VladVeliciu/PWM_generator/README.md

# PWM_generator (01/04/2022 - 17/05/2022)
- Circuit was designed in LTSpice simulator with theoretically calculations and standardization of components
- Simulations to demonstrate the functionality of the circuit with the standard, real components (with tolerances)
- Documentation to explain the computing, design, standardization and simulation process
