VladVeliciu/PWM_generator/PWM Generator.pptx

## PWM Generator

Vlad Veliciu
Faculty of Electronics, Telecommunication and Information Technology, TUC-N

## Description and functionality of the circuit

- Design parameters:
  - Duty cycle: 10%-50%
  - Amplitude: 3V-5V
  - F=12000 Hz

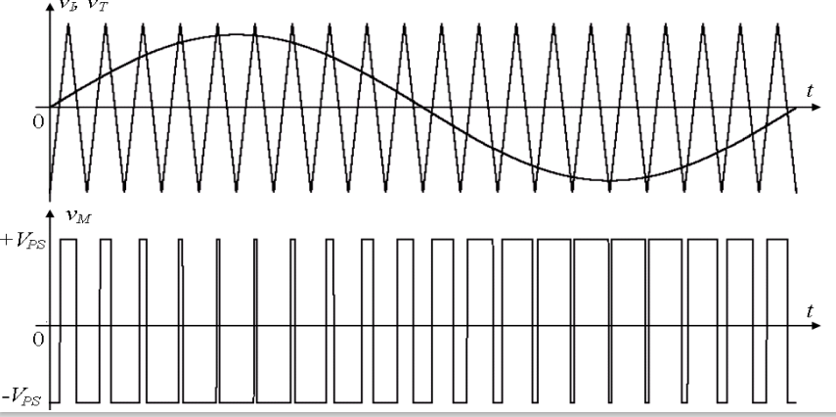
[picture p1: figure]
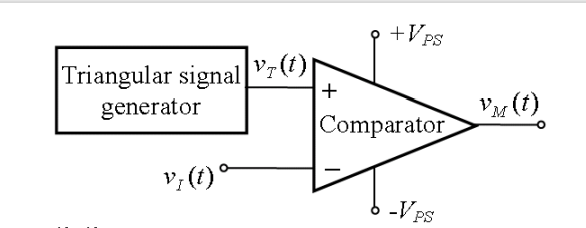
[picture p2: figure]

Vi(t) can be a sine wave or a DC signal

## Block Diagram

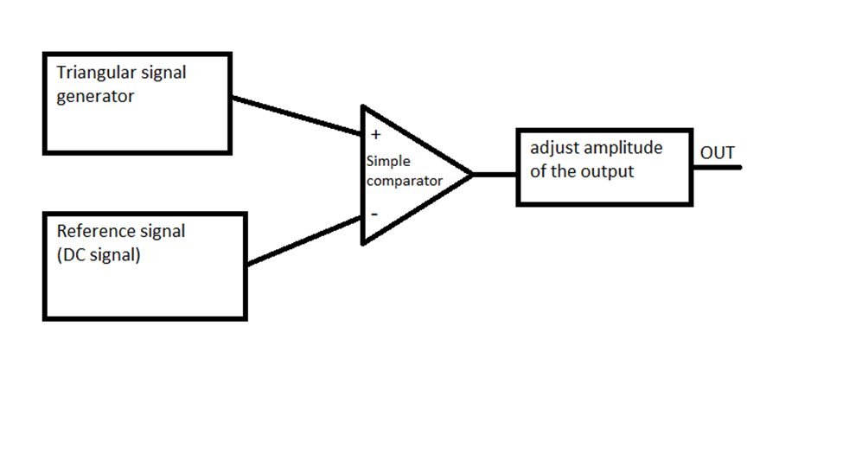
[picture p3: figure]

## Electrical schematic and theoretically computed values for components

- Triangular signal generator
  - Design formula: f=(R_2)/(4∗R∗C∗R_1)=12000 where R2>R1 (necessary condition for oscillation). Take R2=2∗R1
  - {, R_1 =2kΩ, R_2 =4kΩ, R=8kΩ, C=5.2nF
  - R5=R=2kΩ; R6=R1||R2=1.34kΩ
  - For VTriang: V_(max) =3V and V_(min) =−3V

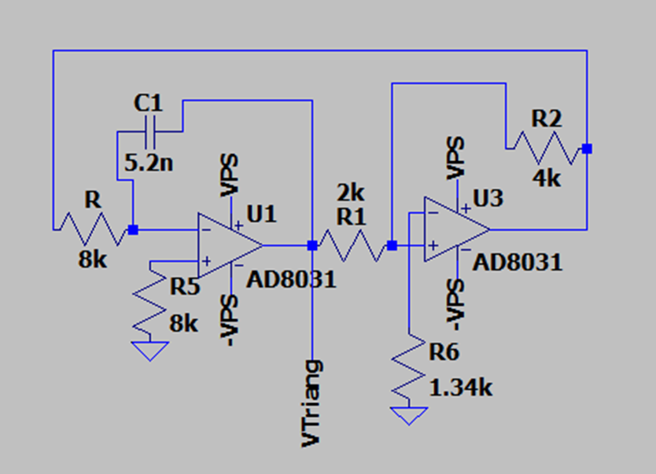
[picture p4: figure]

VPS=6V

## Electrical schematic and theoretically computed values for components

- Reference (DC) signal
  - D=(T_(on))/T∗100
  - For D=10% (whole R7 used) ->
(Ampl of V_(Triang))/(, , Ampl of V_(Triang) −VIN)=(T/2)/(t_(in))=>VIN=2.4 V
  - For D=50% (R7 not used) => VIN=0 V
  - By applying voltage divider: R_7 =1kΩ and R_4 =1.5kΩ

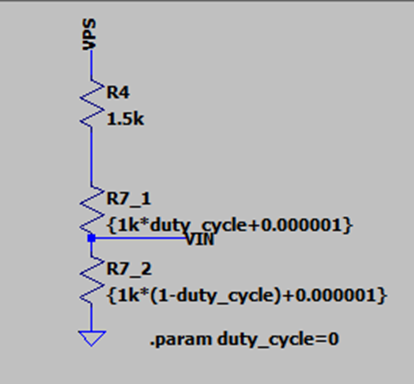
[picture p5: figure]
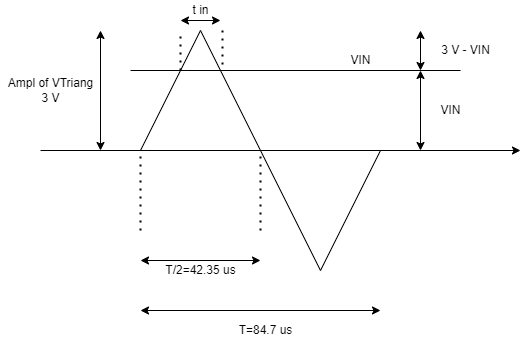
[picture p6: figure]

## Electrical schematic and theoretically computed values for components

- Simple comparator
  - At every intersection of VIN with VTriang, a switch of the output signal (between VPS and –VPS) happens

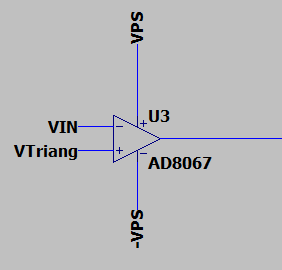
[picture p7: figure]

## Electrical schematic and theoretically computed values for components

- Adjust amplitude at the output circuit
  - R_8 =1k , R_9 =0.5kΩ and R_3 =1.5kΩ
  - Class B amplifier with global negative feedback (neglectable distortions)
  - Needs a higher voltage supply than the “followed” -> VPS=6V

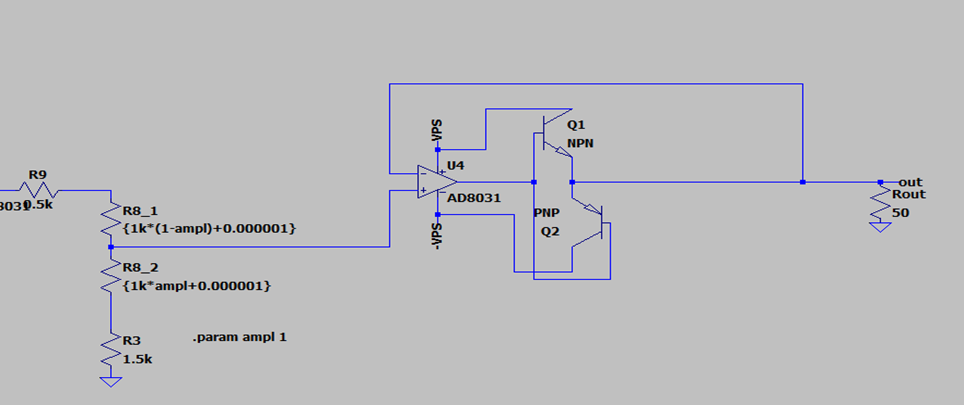
[picture p8: figure]

## Electrical schematic and theoretically computed values for components

- Schematic with theoretically computed values

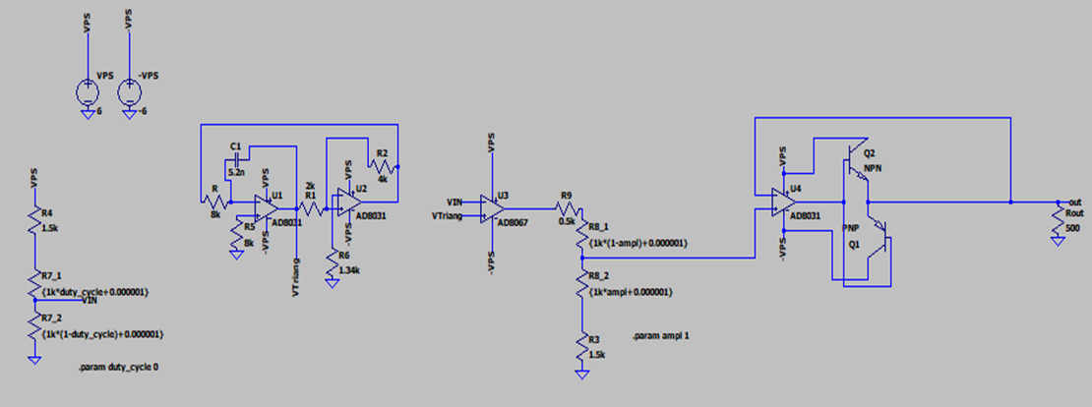
[picture p9: figure]

## Choosing standard components

- OpAmps
  - Rail-to-rail AD8031 - triangular signal generator and class B amplifier (slew rate=30V/us), low power amplifier
  - Rail-to-rail AD8067 – simple comparator (slew rate=640V/us) -> quick stabilization

## Choosing standard components

- Passive components and transistors
  - C1=5.1 nF (+/- 10%)
  - R1=2 kΩ (+/- 0.5%)
  - R2=4.02 kΩ (+/- 0.05%)
  - R=R5=8.06 kΩ (+/- 0.5%)
  - R6=1.35 kΩ (+/- 5%)
  - R4=1.5 kΩ (+/- 1%)
  - R7=1 kΩ (+/- 20%)
  - R9=2 kΩ (+/- 0.1%)
  - R8=1 kΩ (+/- 20%)
  - R3=1.5 kΩ (+/- 1%)
  - Q2=BJT npn 2N2222 (Ic=600 mA)
  - Q1=BJT pnp 2N2907 (Ic=600 mA)

## Simulations and Analysis

- Time-domain simulation
- Amplitude=5V
- VIN=2.4V
- D=10%

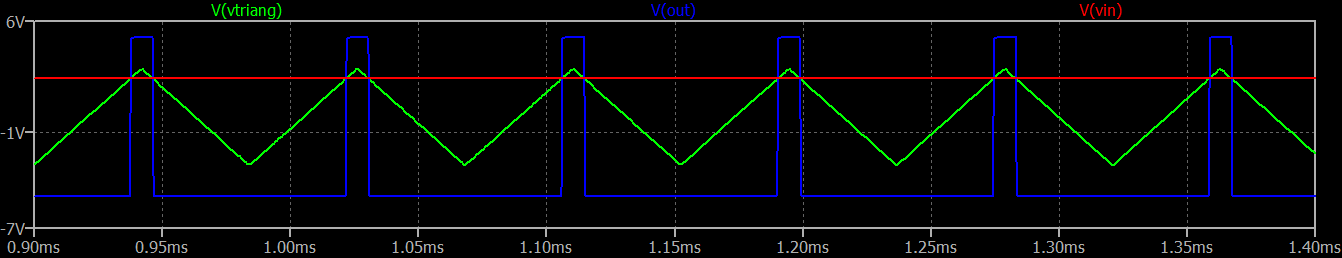
[picture p10: figure]

F=11874 Hz

## Simulations and Analysis

- Parametric analysis – varying duty cycle (potentiometer R7)
  - VIN variation:

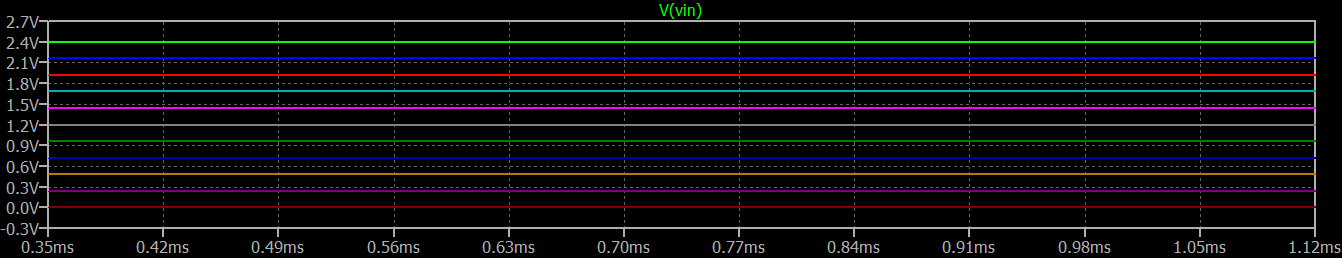
[picture p11: figure]
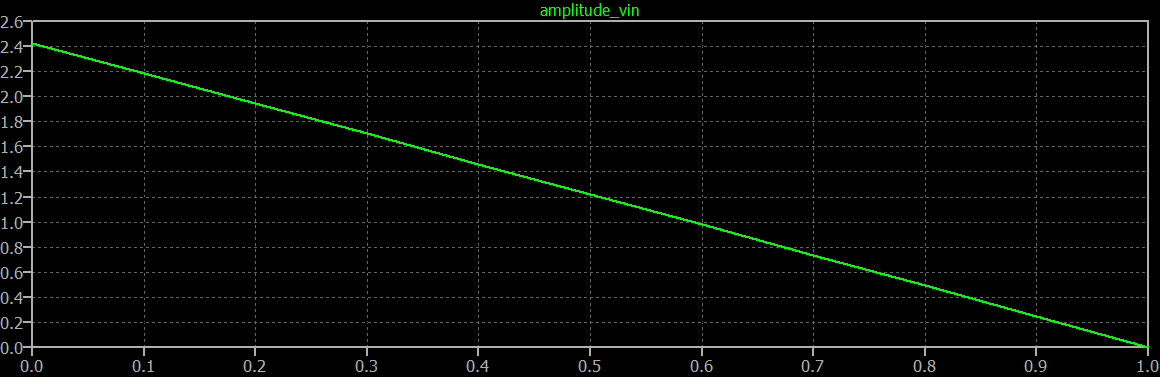
[picture p12: figure]

VIN decreases (2.4V-0V) linearly with the increase of the percentage of the used potentiometer

## Simulations and Analysis

- Parametric analysis – varying duty cycle
  - Vout variation: (Amplitude=5V)

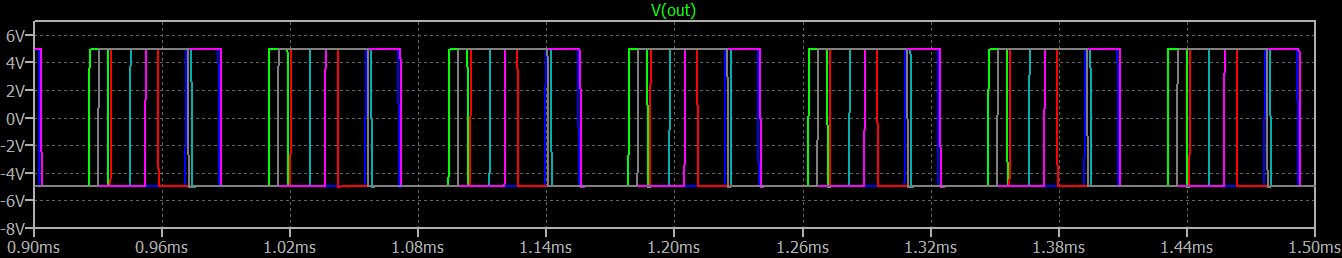
[picture p13: figure]
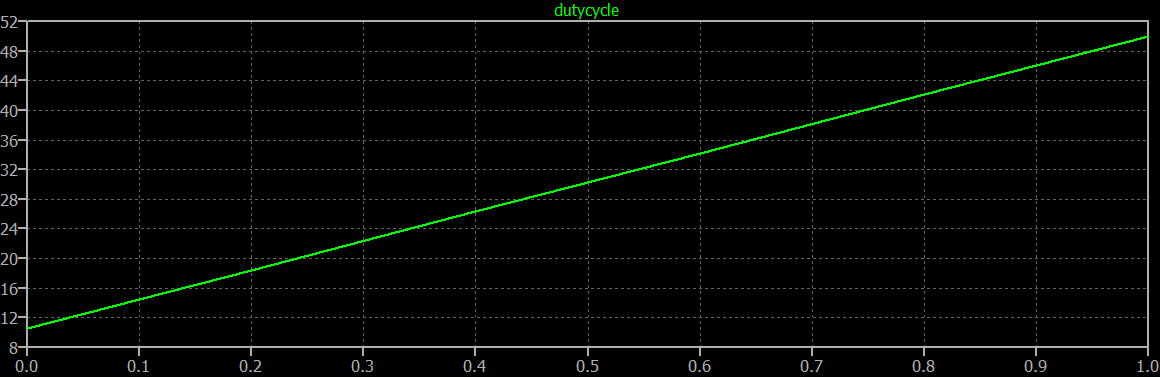
[picture p14: figure]

Duty cycle varies linearly

## Simulations and Analysis

- Parametric analysis – varying amplitude (potentiometer R8)
  - Vout variation (duty cycle=50%)

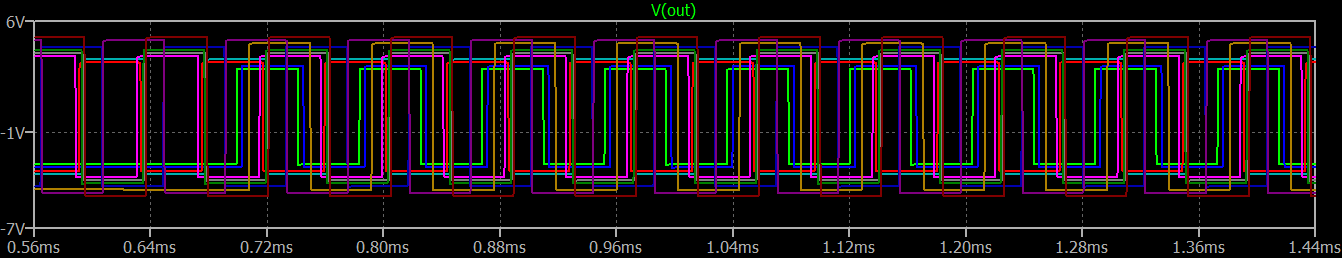
[picture p15: figure]
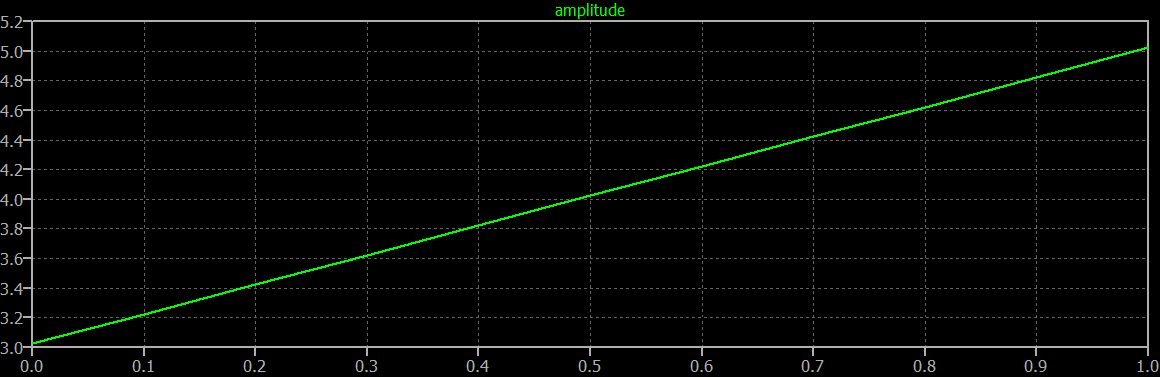
[picture p16: figure]

Amplitude varies linearly

## Simulations and Analysis

- FFT (Fast Fourier Transform)
  - Output signal (rectangular)
  - Ampl=5V, D=50%

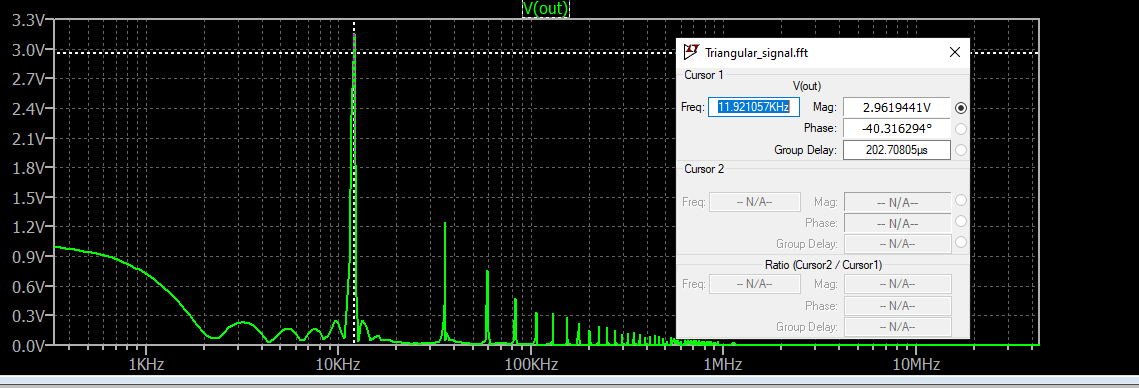
[picture p17: figure]

2/T ∗A∗τ∗sinc(π∗n∗f∗τ)

At f=12kHz => Spectrum = 3.18V

## Simulations and Analysis

- FFT (Fast Fourier transform)
  - Triangular signal (Amplitude = 3V):

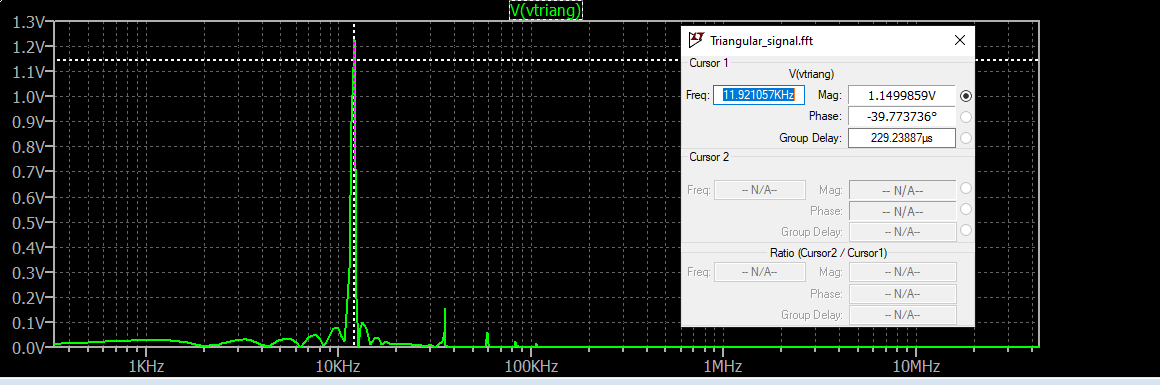
[picture p18: figure]

2/T ∗A∗τ/2∗sinc^2 (π∗n∗f∗τ/2)

For f=12kHz => Spectrum = 1.21 V

## Simulations and Analysis

- Monte Carlo analysis
  - Adding tolerances to the components
  - Variation of Vout in time (Ampl=5V, D=10%):

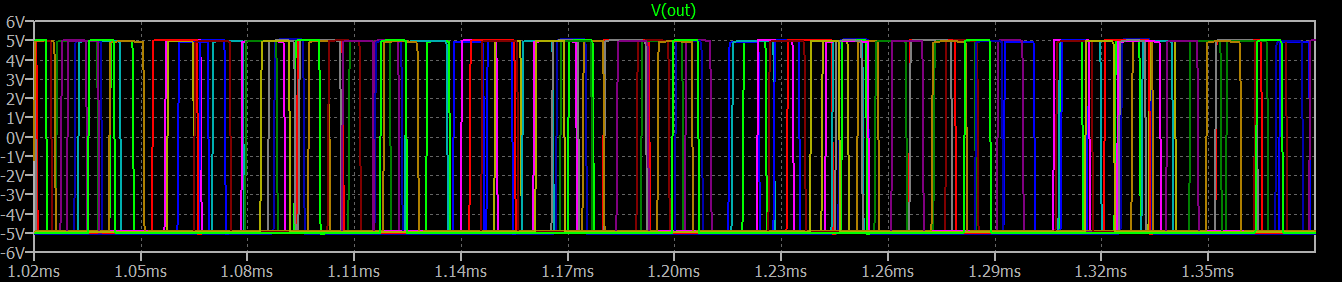
[picture p19: figure]

## Simulations and Analysis

- Monte Carlo analysis
  - Variation of the amplitude:

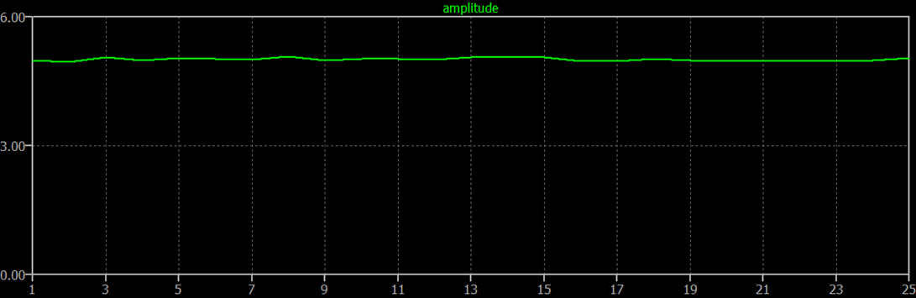
[picture p20: figure]

Small variation of the amplitude: 4.94V-5.07V

## Simulations and analysis

- Monte Carlo analysis
  - Variation of the frequency:

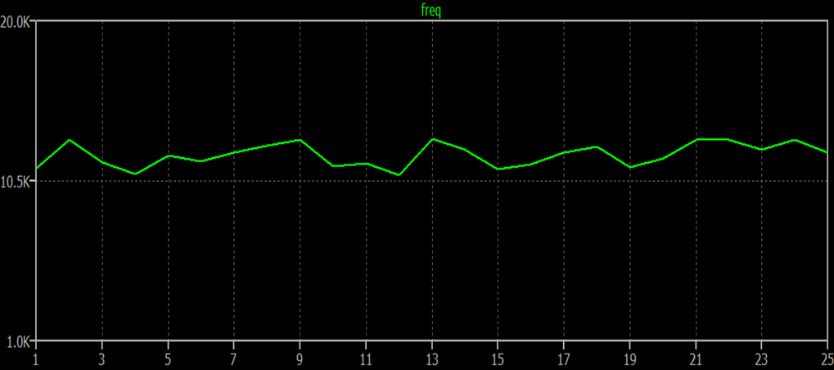
[picture p21: figure]

Variation of the frequency: 10.88kHz-13kHz

## Simulations and analysis

- Monte Carlo analysis
  - Variation of VIN and of the amplitude of the triangular signal:

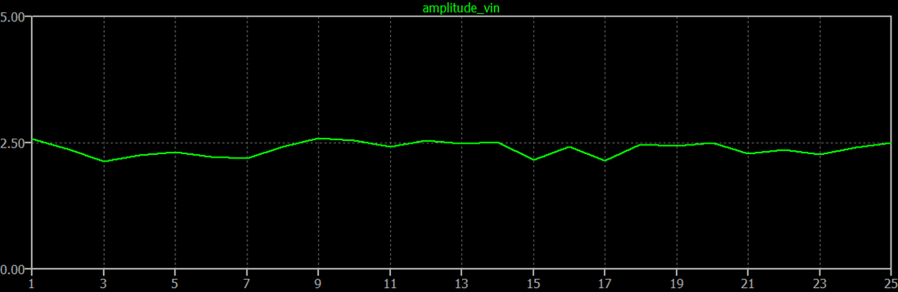
[picture p22: figure]

VIN varies between 2.15V and 2.58 V out of 2.4V

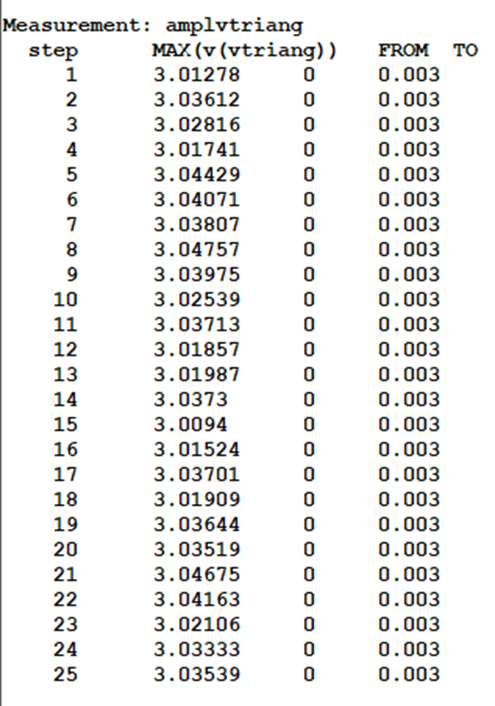
[picture p23: figure]

Amplitude Vtriang doesn’t have a significant variation – around 3.02V

## Simulations and analysis

- Monte Carlo analysis
  - Variation of the duty cycle, knowing that (Ampl of V_(Triang))/(Ampl of V_(Triang) −VIN)=(T/2)/(T_(on)) and D=(T_(on))/T∗100 :

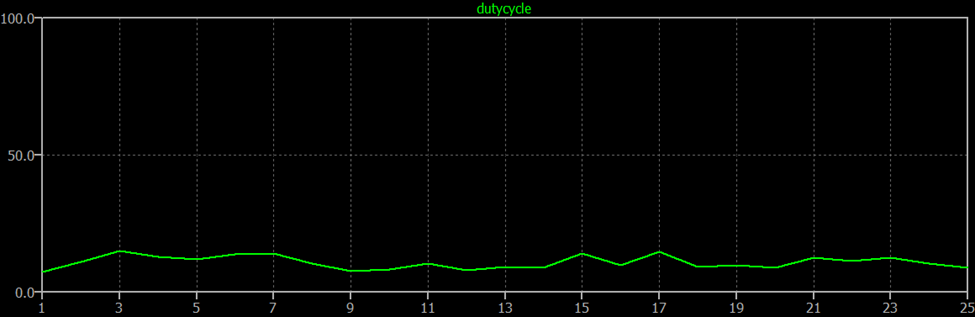
[picture p24: figure]

Duty cycle has a small variation: 7.29%-15% out of 10%

## Bill of materials

Nr Crt | Model name | Description | Units | Comp | Price per unit [RON] | Total price [RON]
1 | AD8031ARTZ-REEL7 | Operational Amplifiers - Op Amps SOT23 SINGLE LOW POWER OP AMP | 3 | U1, U2, U4 | 8.86 | 26.58
2 | AD8067ARTZ-REEL7 | Precision Amplifiers High Gain Band Width High Perf Fast FET | 1 | U3 | 18.32 | 18.32
3 | CC0805KRX7R9BB512 | Multilayer Ceramic Capacitors MLCC - SMD/SMT 50V 5100pF X7R 0805 10% | 1 | C1 | 0.09 | 0.09
4 | ERJ-1RHD2001C | Thick Film Resistors - SMD 0201 chip resistor (R=2k) | 1 | R1 | 0.08 | 0.08
5 | RG1608P-4021-W-T5 | Thin Film Resistors - SMD 1/10W 4.02K Ohm .05% 0603 25ppm | 1 | R2 | 0.77 | 0.77
6 | ERJ-6RBD8061V | Thick Film Resistors - SMD 0805 Resistor 0.5% 50ppm 8.06KOhm | 2 | R, R5 | 0.08 | 0.08
7 | RT0603DRE071K35L | Thin Film Resistors - SMD 1/10W 1.35K Ohms .5% | 1 | R6 | 0.05 | 0.05
8 | 302-1.5K-RC | Thick Film Resistors - SMD 1/10WATT 1.5KOHMS | 2 | R4, R3 | 0.005 | 0.01
9 | P160KN-0QC15B1K | Potentiometers 1/5W 1K Ohms 20% 16mm ROTARY POT | 2 | R7, R8 | 2.53 | 5.06
10 | RN732ATTD5000B25 | Thin Film Resistors - SMD 500Ohm,0805,0.1%,25p | 1 | R9 | 0.52 | 0.52
11 | 2N2222A | Bipolar Transistors - BJT Bipolar Transistor, TO-92, 40V, 600mA, NPN | 1 | Q2 | 0.39 | 0.39
12 | 2N2907A | Bipolar Transistors - BJT Bipolar Transistor, TO-92, 60V, 600mA, PNP | 1 | Q1 | 0.39 | 0.39
TOTAL | | | | | | 52.34

## References

1. https://www.circuitsgallery.com/pwm-generator-circuit-using-741-op-amp/
2. https://www.sciencedirect.com/topics/engineering/pulse-width-modulation
3. https://electronicspost.com/generation-and-detection-of-a-pwm-signal/
4. http://www.bel.utcluj.ro/dce/didactic/fec/22_power_amplifier_class_D.pdf
5. http://www.bel.utcluj.ro/dce/didactic/fec/20_nonsinusoidal_oscillators.pdf
6. http://www.bel.utcluj.ro/dce/didactic/fec/
7. AD8067 (Rev. B) (analog.com) (https://www.analog.com/media/en/technical-documentation/data-sheets/AD8067.pdf)
8. AD8031/AD8032 (Rev. G) (analog.com) (https://www.analog.com/media/en/technical-documentation/data-sheets/AD8031_8032.pdf)
9. Teoria (http://bel.utcluj.ro/scs/rom/ts_main.html)Semnalelor (http://bel.utcluj.ro/scs/rom/ts_main.html) (utcluj.ro) (http://bel.utcluj.ro/scs/rom/ts_main.html)
10. Electronic Components Distributor - Mouser Electronics Romania (https://ro.mouser.com/)
