VladVeliciu/PWM_generator/Triangular_signal.asc

-VPS: voltage; -6
C1: cap; {mc(5.1n,tol7)}
Q1: pnp; 2N2907
Q2: npn; 2N2222
R1: res; {mc(2k,tol2)}
R2: res; {mc(4.02k,tol3)}
R3: res; {mc(1.5k,tol5)}
R4: res; {mc(1.5k,tol5)}
R5: res; {mc(8.06k,tol2)}
R6: res; {mc(1.35k,tol4)}
R7_1: res; {mc({1k*duty_cycle+0.000001},tol1)}
R7_2: res; {mc({1k*(1-duty_cycle)+0.000001},tol1)}
R8_1: res; {mc({1k*(1-ampl)+0.000001},tol1)}
R8_2: res; {mc({1k*ampl+0.000001},tol1)}
R9: res; {mc(0.5k,tol6)}
R: res; {mc(8.06k,tol2)}
Rout: res; 50
U1: AD8031
U2: AD8031
U3: AD8067
U4: AD8031
VPS: voltage; 6
Named nets: 0, VPS, -VPS, VTriang, VIN, out
.tran 0 3ms 0 20us
.param duty_cycle 0
.param ampl 1
.meas tran amplitude_VIN max V(vin)
.meas tran amplitude max V(out)
.step param run 1 25 1
.param tol1=0.2
.param tol2=0.005
.param tol3=0.0005
.param tol4=0.05
.param tol5=0.01
.param tol6=0.001
.param tol7=0.1
.meas tran t1 V(out) when V(out)=0 rise=2
.meas tran t2 V(out) when V(out)=0 fall=2
.meas tran freq param 1/(t3-t1)
.step param duty_cycle 0 1 0.2
.step param ampl 0 1 0.1
.meas tran t3 V(out) when V(out)=0 rise=3
.meas tran amplVTriang max V(VTriang)
.meas tran dutyCycle param (t2-t1)/(t3-t1)*100
